Vitech-UA/Lamp_audio_amplifier_6P14P_6N2P/README.md

# 🎛️ Відновлення лампового ПНЧ з магнітофона **Дніпро-14**

## Вигляд магнітофона Дніпро-14:

Підсилювач низької частоти (ПНЧ) на лампах із бабінного магнітофона **Дніпро-14**. Схема заснована на лампах **6Н2П**, **6П14П** та **індикаторі 6Е1П**.

Оригінальна схема

---

## 🔧 Змонтована плата **v1**

Першу версію плати змонтовано згідно з класичною схемою. Основна мета — зберегти автентичне звучання лампового підсилювача.

**Фото плати v1:**

| ТОР | BOT |
|---|---|
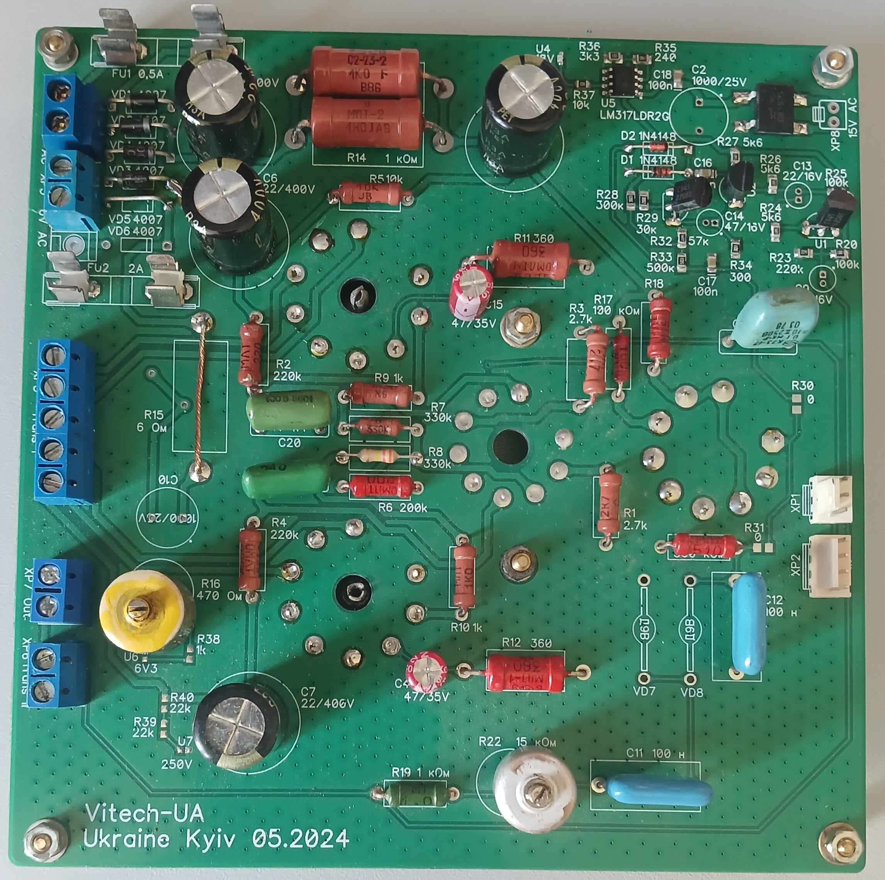
[picture p1: MEDIA/20250723_142210.jpg]
V1 Front
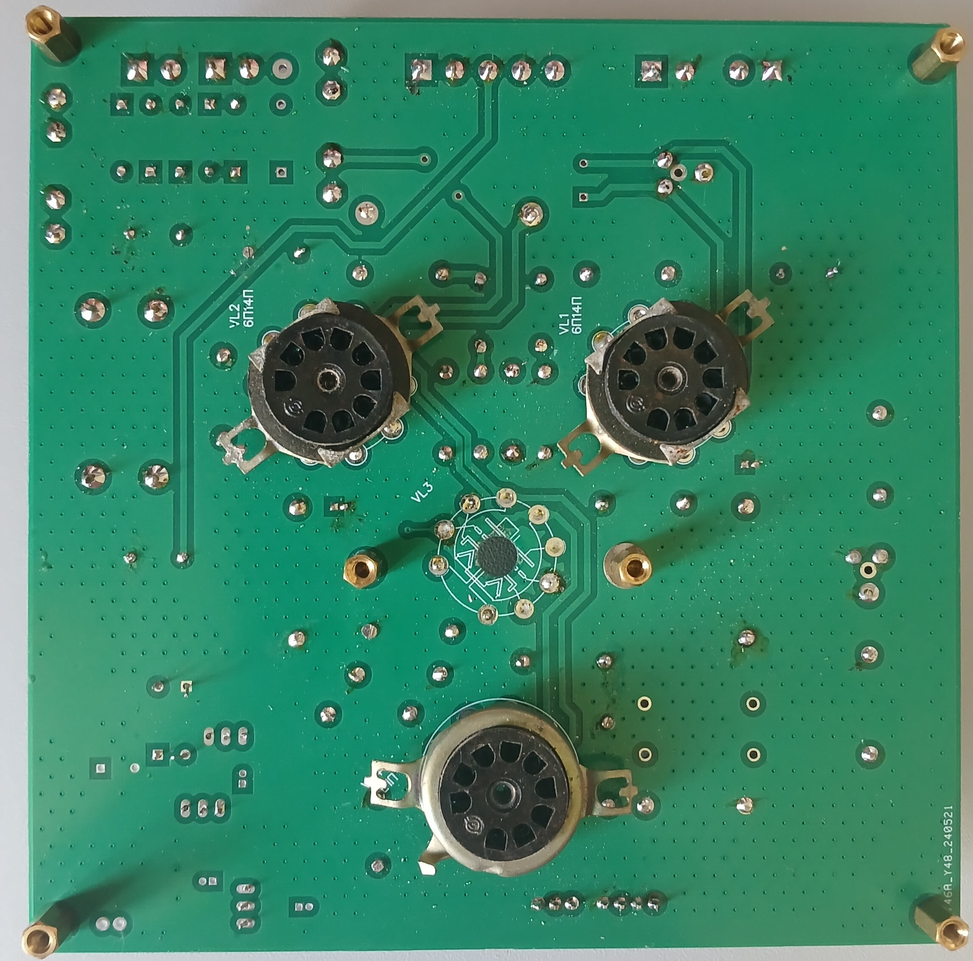
[picture p2: MEDIA/20250723_142150.jpg]
V1 Rear
|  |  |

---

## 🔁 Зміни у версії **v2**

Оновлена версія враховує виправлення та покращення v1. Основні зміни:

- Додано маркування транзисторів **VT1–VT3 → 2N2222**
- **R18:** 150 кОм → **0 Ом**
- **R17:** 100 кОм → **150 кОм**
- Виводи **9, 3, 8 лампи 6Е1П** тепер напряму підключені до **+300 В** (без резистора 150 кОм) див п.2
- Вхідний сигнал на **6Е1П** подається з **регулятора гучності**, а не з вихідного трансформатора
- Додано дросель **L1** для фільтрації живлення **+300 В**
- ⚙Додано снабер-ланку **C5–R15** згідно з оригінальною схемою
- Аноди **VD1** і **VD3** тепер **заземлені**
- На платі додано підпис призначення виводів **XP3**

---

## 3D-модель плати **v2**

**Вигляд зверху (TOP):**  
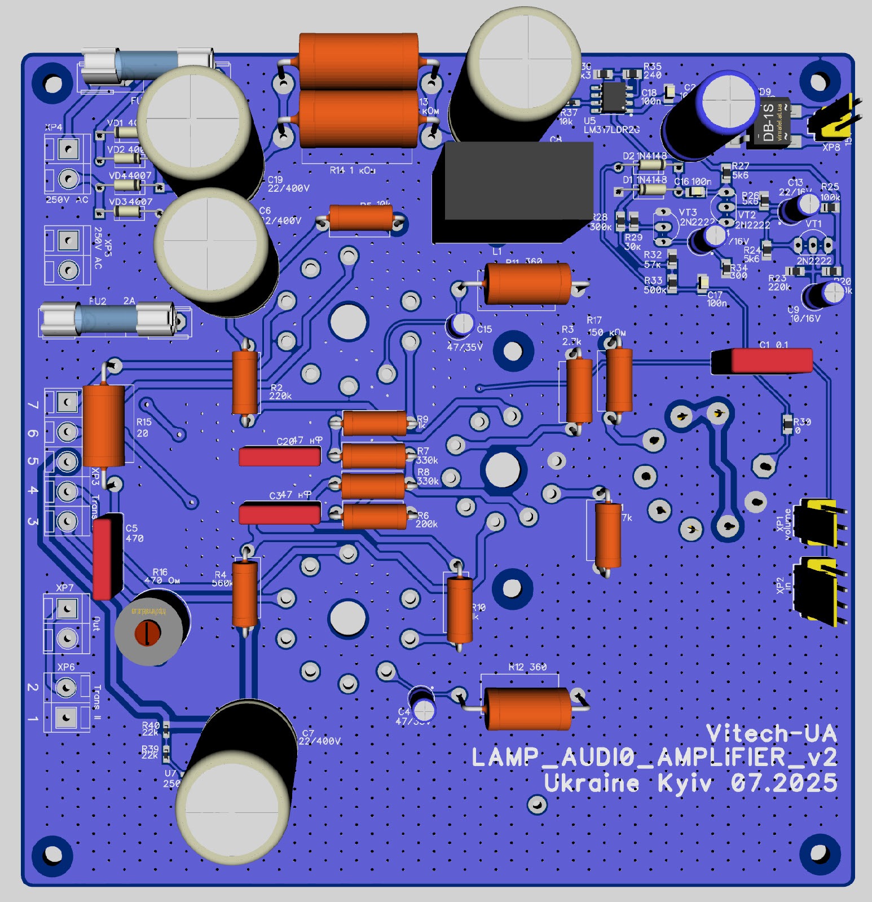
[picture p3: MEDIA/2025-07-23_14-13-58.jpg]
3D Top


**Вигляд знизу (BOTTOM):**  
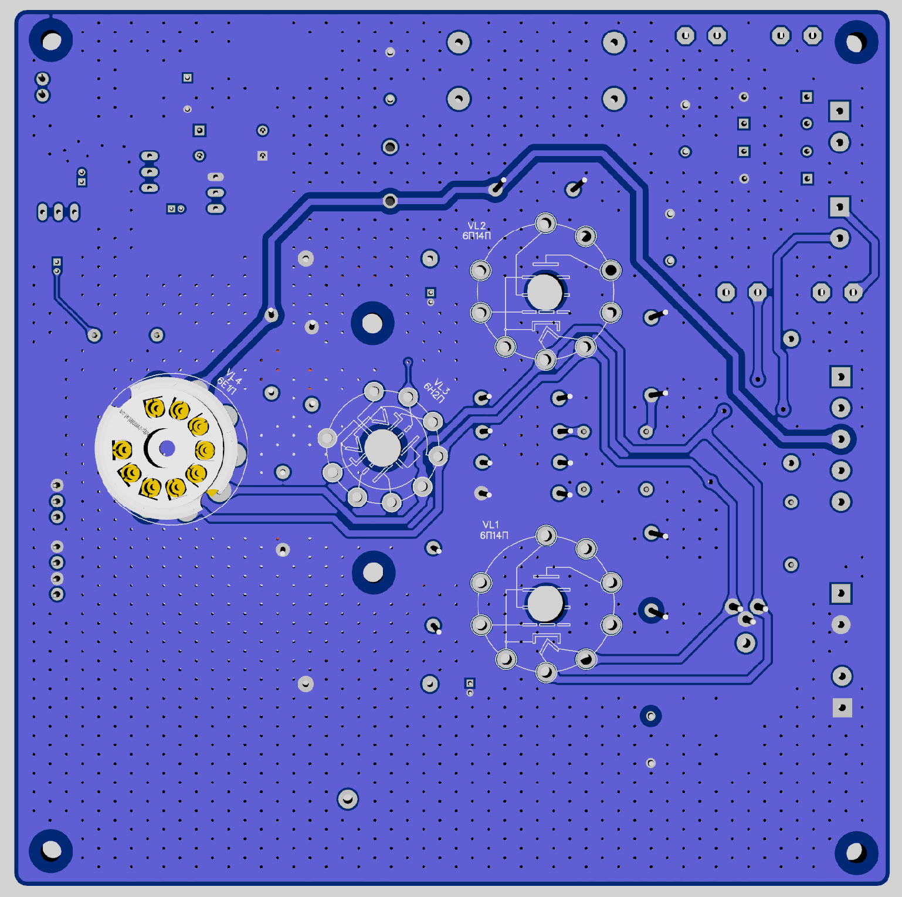
[picture p4: MEDIA/2025-07-23_14-14-08.jpg]


---

## Зібраний робочий апарат:

**Фото зібраного підсилювача зпереду:**  
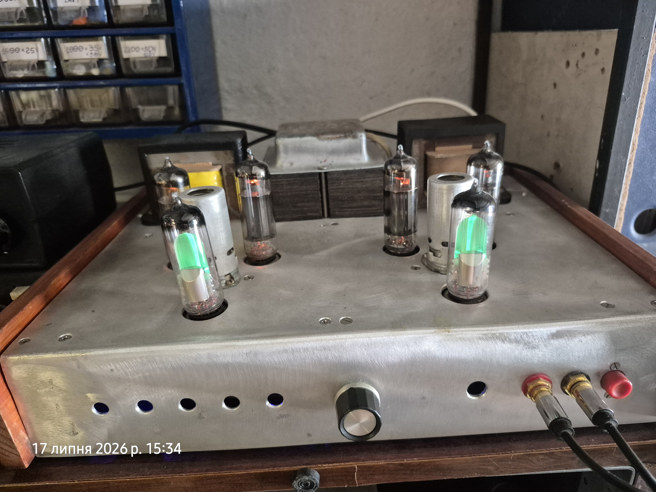
[picture p5: MEDIA/CASE1.jpg]
Front


**Монтаж:**  
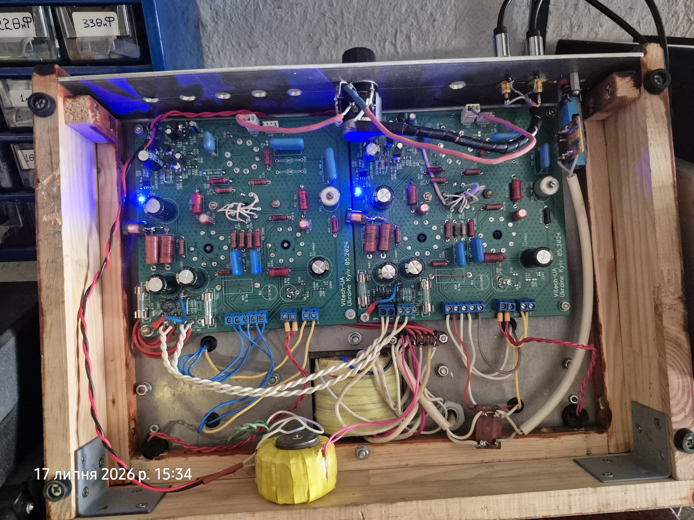
[picture p6: MEDIA/CASE2.jpg]


**Лампи 6Е1П:**  
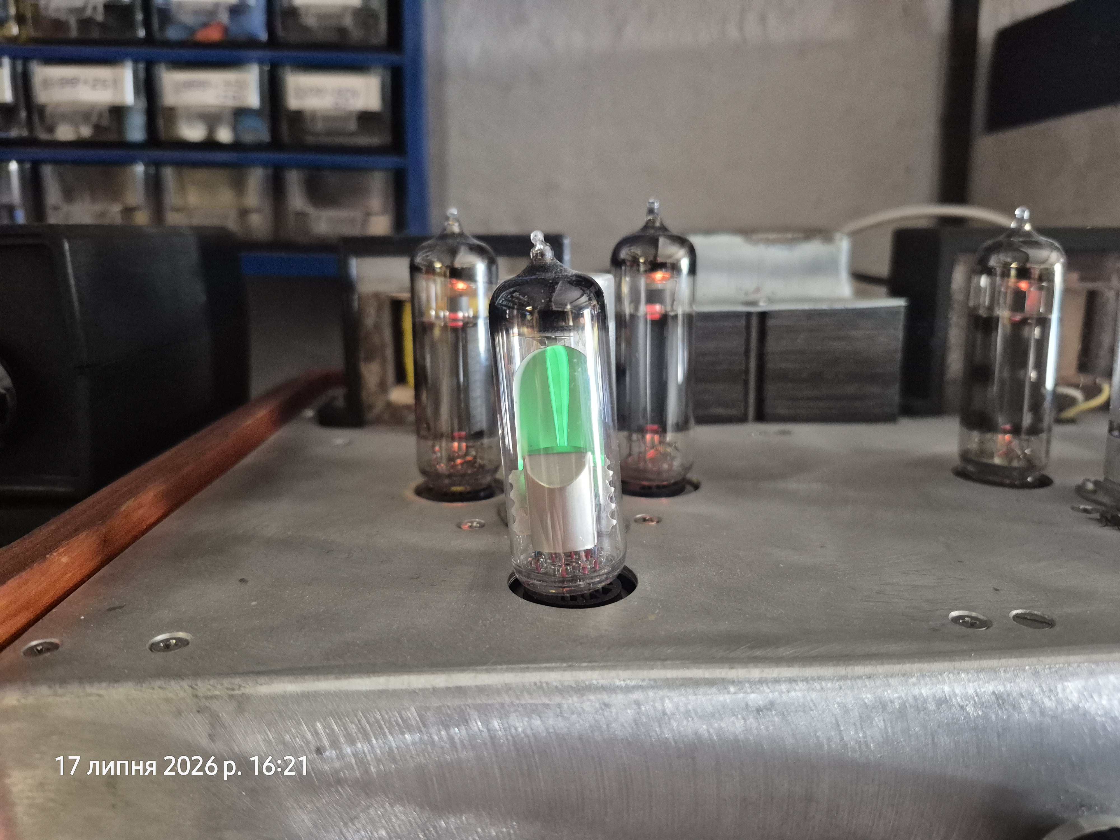
[picture p7: MEDIA/CASE3.jpg]

---
## 📎 Посилання

🔗 [GitHub репозиторій проєкту](https://github.com/Vitech-UA/Lamp_audio_amplifier_6P14P_6N2P)

---

## 📢 Примітки

Проєкт має історичну цінність, адже базується на оригінальній схемі лампового магнітофона 1970-х років. При цьому були застосовані сучасні методи проєктування друкованих плат (CAD, 3D-моделювання, перехід на кремнієві транзистори у допоміжних вузлах).

---

🛠 **Автор:** [Vitech-UA](https://github.com/Vitech-UA)  
📅 **Оновлено:** 23 липня 2025 року
