Vitech-UA/Lamp_audio_amplifier_6P14P_6N2P/MEDIA/Відновлення/20210327_094951.jpg

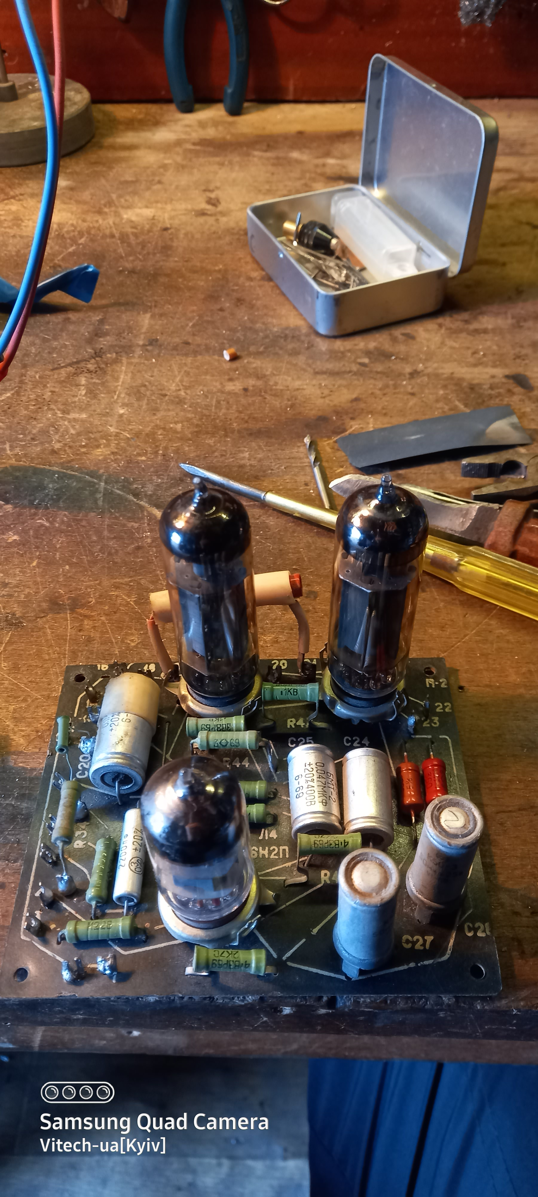
MEDIA/Відновлення/20210327_094951.jpg
