Vitech-UA/Lamp_audio_amplifier_6P14P_6N2P/MEDIA/Відновлення/20210415_182930.jpg

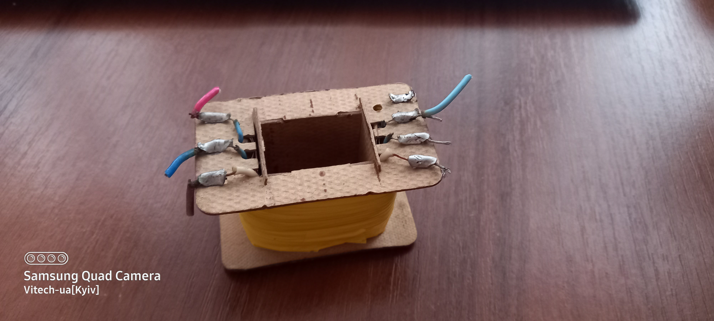
MEDIA/Відновлення/20210415_182930.jpg
