Vitech-UA/Lamp_audio_amplifier_6P14P_6N2P/MEDIA/Відновлення/Макет.jpg

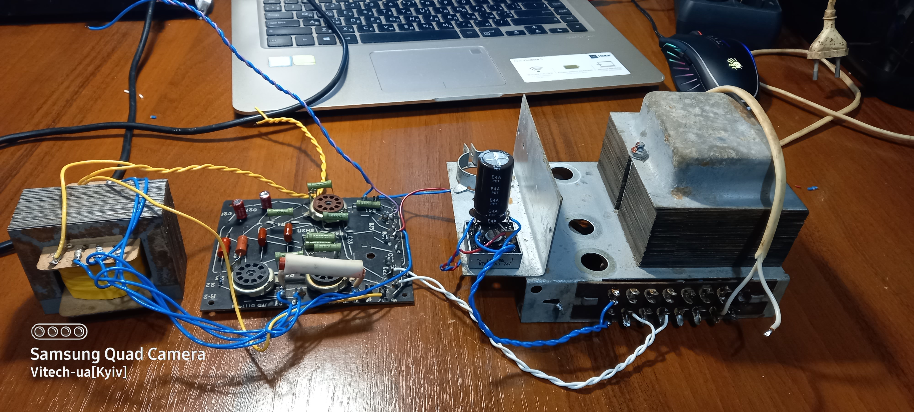
MEDIA/Відновлення/Макет.jpg
