Vitech-UA/Lamp_audio_amplifier_6P14P_6N2P/MEDIA/Корпус/20250720_005303.jpg

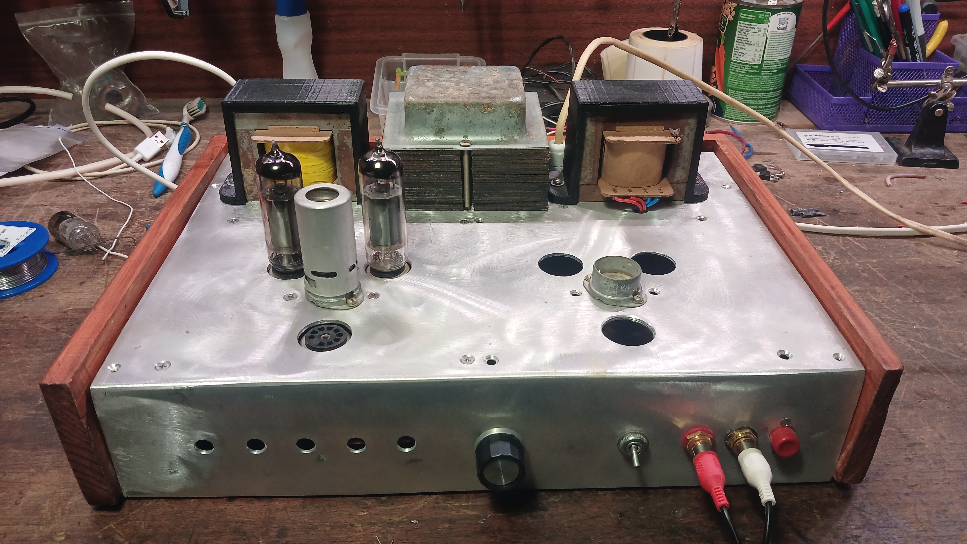
MEDIA/Корпус/20250720_005303.jpg
