Vitech-UA/Lamp_audio_amplifier_6P14P_6N2P/MEDIA/Корпус/photo_1_2024-10-20_21-03-49.jpg

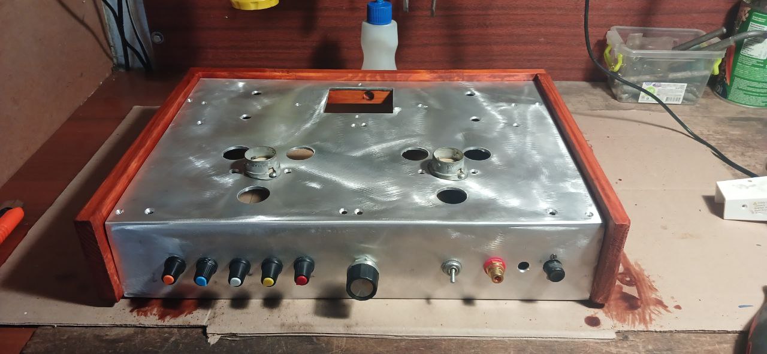
MEDIA/Корпус/photo_1_2024-10-20_21-03-49.jpg
