Vitech-UA/Lamp_audio_amplifier_6P14P_6N2P/MEDIA/Корпус/Підключення трансформатора до плати.jpg

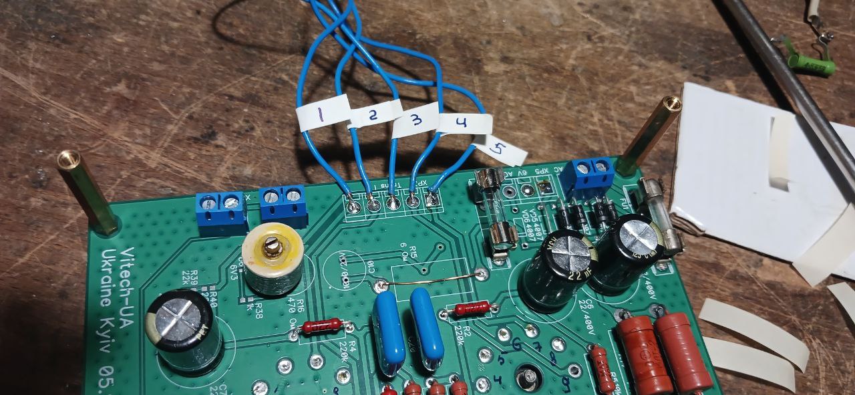
MEDIA/Корпус/Підключення трансформатора до плати.jpg
