Vitech-UA/Lamp_audio_amplifier_6P14P_6N2P/Карта виводів вих транса.jpg

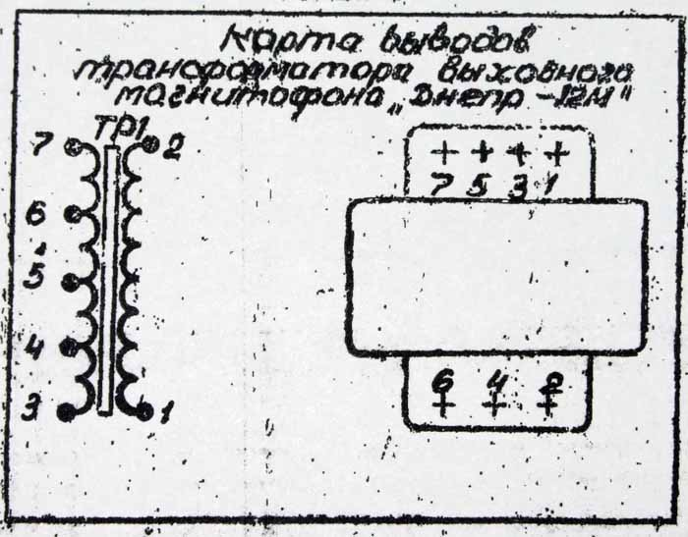
Карта виводів вих транса.jpg
