Vitech-UA/Lamp_audio_amplifier_6P14P_6N2P/Ламповий УСЬ.jpg

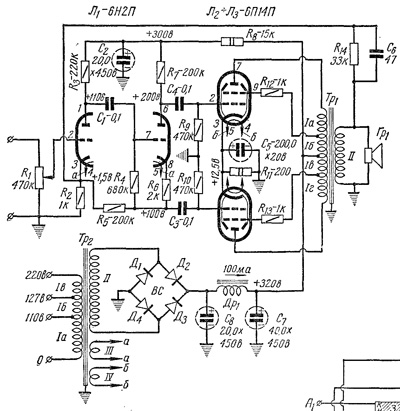
Ламповий УСЬ.jpg
