Vitech-UA/Lamp_audio_amplifier_6P14P_6N2P/Обвязка 6е1п.jpg

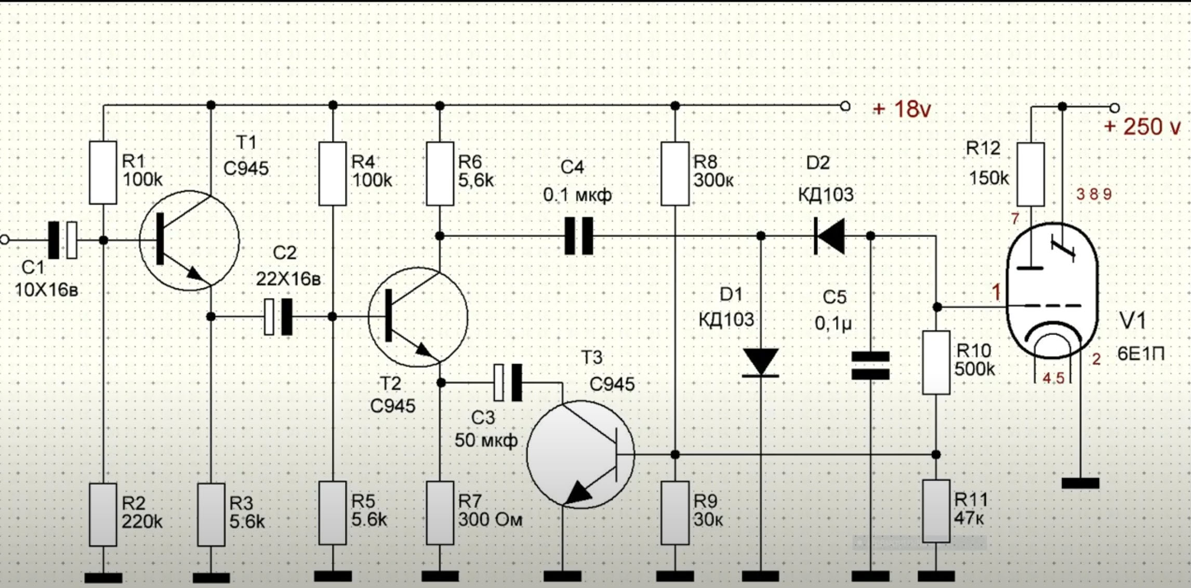
Обвязка 6е1п.jpg
