Vitech-UA/Lamp_audio_amplifier_6P14P_6N2P/Параметри вихідного транса.jpg

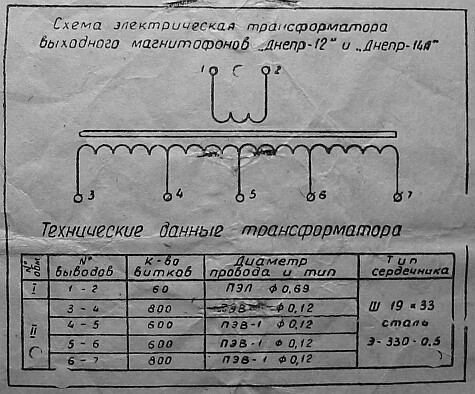
Параметри вихідного транса.jpg
