Vitech-UA/Lamp_audio_amplifier_6P14P_6N2P/параметри обмоток вихідного трансформатора після перемотки 6-7_11.04.2021.jpg

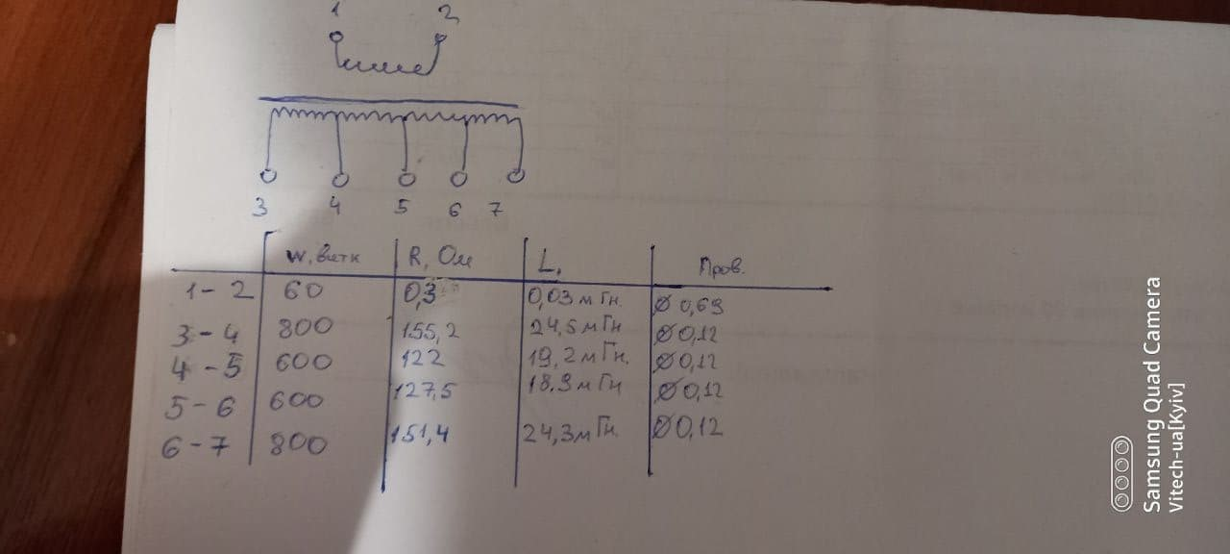
параметри обмоток вихідного трансформатора після перемотки 6-7_11.04.2021.jpg
