Vitech-UA/Lamp_audio_amplifier_6P14P_6N2P/(list of files, drawings)

Other design files:
CAD_SRC_DipTrace/PCB.dip
CAD_SRC_DipTrace/sch.dch
