Vitech-UA/Lamp_audio_amplifier_6P14P_6N2P/(commit log)

2021-04-12 Додав моточні дані трансформатора.
2021-11-01 Додав фотки макету
2024-05-19 Додав розводку заводської плати.
    [PCB.dip, sch.dch]
2024-05-19 пофіксив розривив у GND
    [PCB.dip]
2024-05-21 Small fix
    [PCB.dip]
2024-10-27 + iнфо
2025-07-21 Пофіксив схему. Сигнал для 6E1П забираю з входу.
    [sch.dch]
2025-07-23 Вніс правки у плату. Враховуючи помилки виявлені при зборці v1
    [PCB.dip, sch.dch]
2025-07-23 Додав фото змонтованої плати.
2025-07-31 Пофіксив написи на шовкографії.
    [PCB.dip]
2025-09-03 - **R18:** 150 кОм → **0 Ом**
2026-07-18 Додав фото зібраного підсилювача
